Lemure67/SOURCE-CODE/docs/circuit-schematic.png

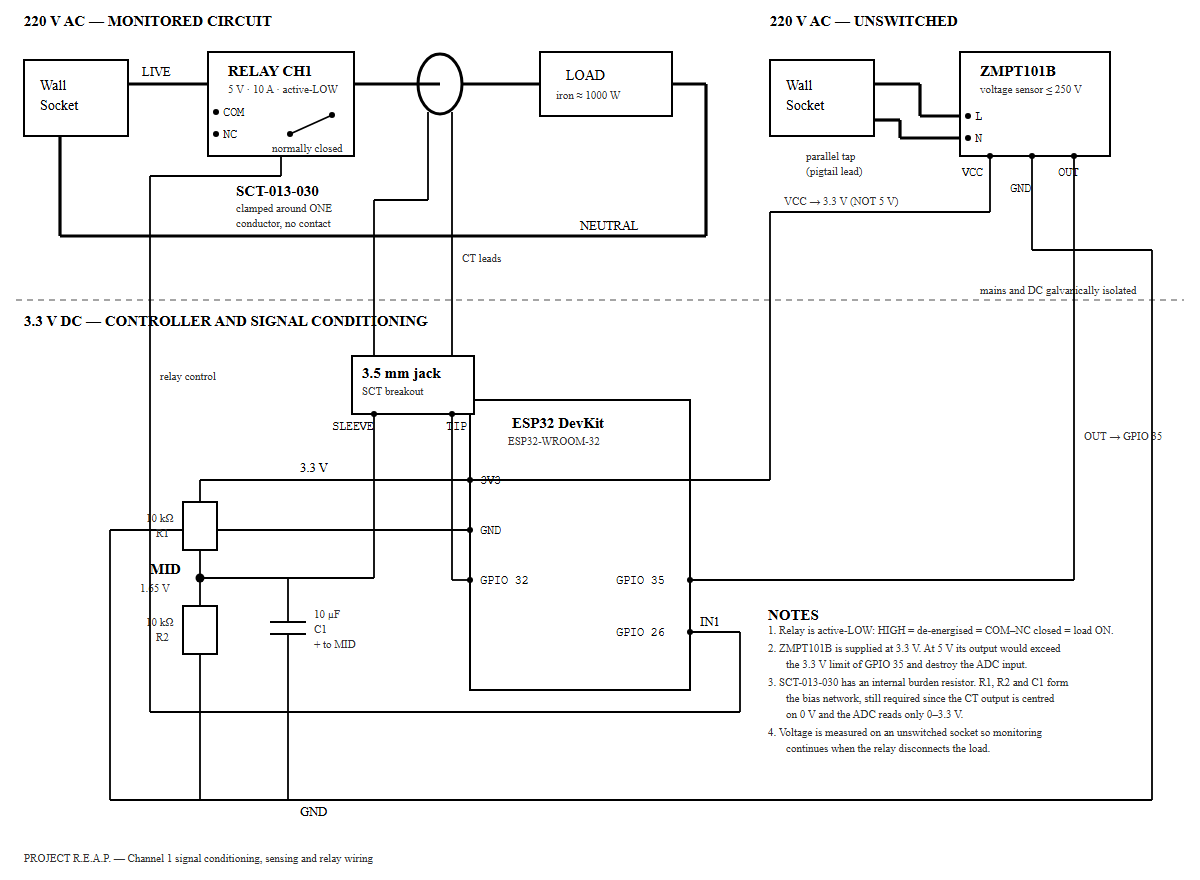
docs/circuit-schematic.png
