Lemure67/SOURCE-CODE/docs/conceptual-framework.png

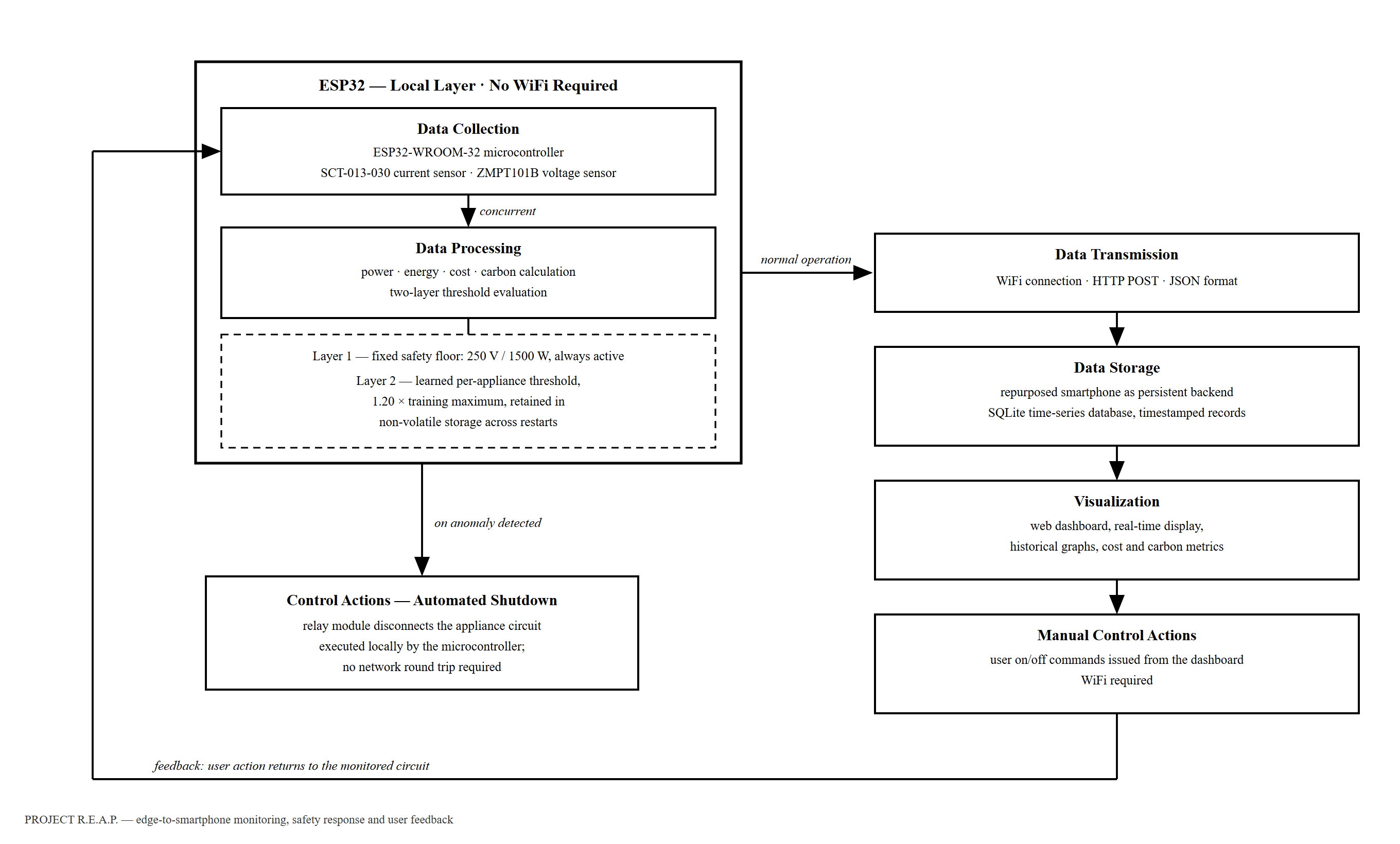
docs/conceptual-framework.png
