Lemure67/SOURCE-CODE/docs/system-architecture.png

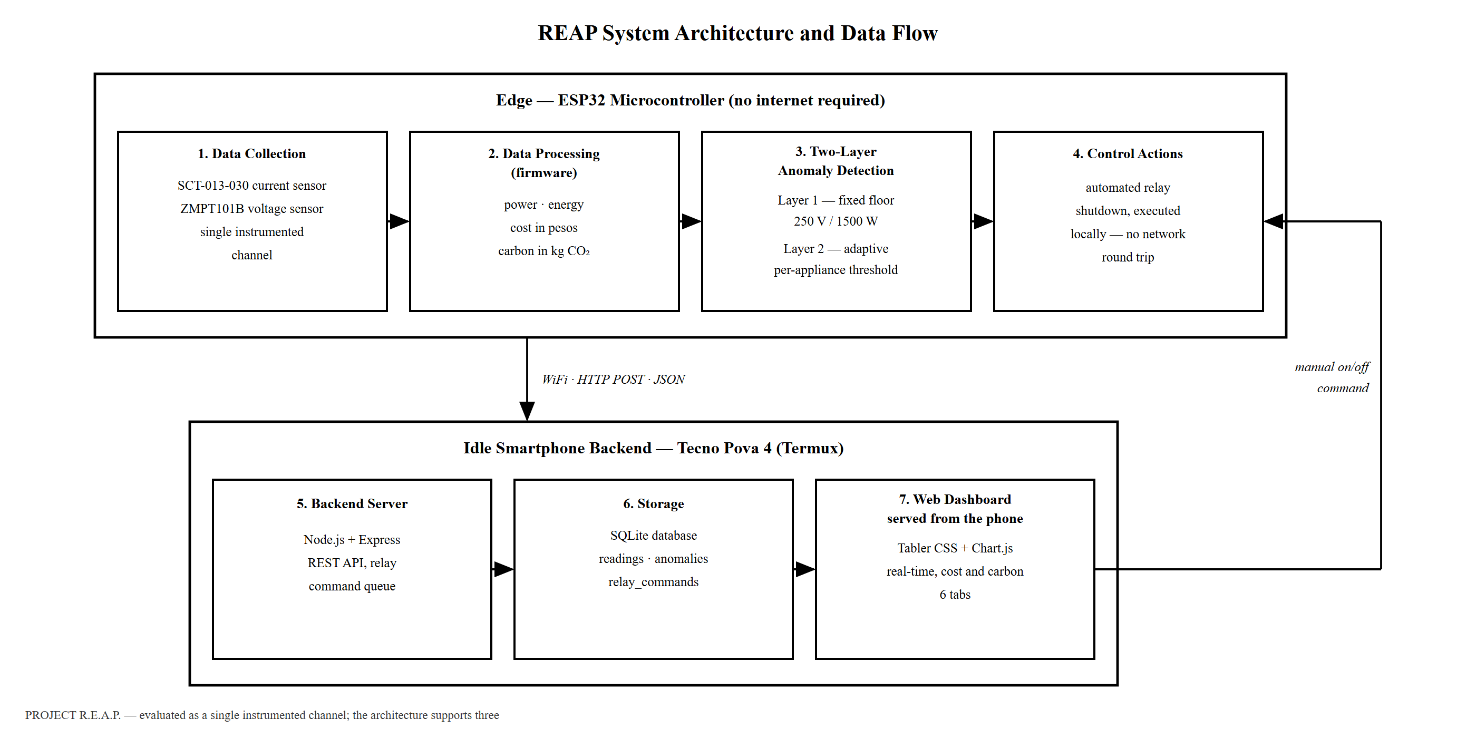
docs/system-architecture.png
